Sonicrobots/Midi-to-10WLED/Eagle Files/8x LED Treiber Stage_01_DOCU_Circuit.pdf

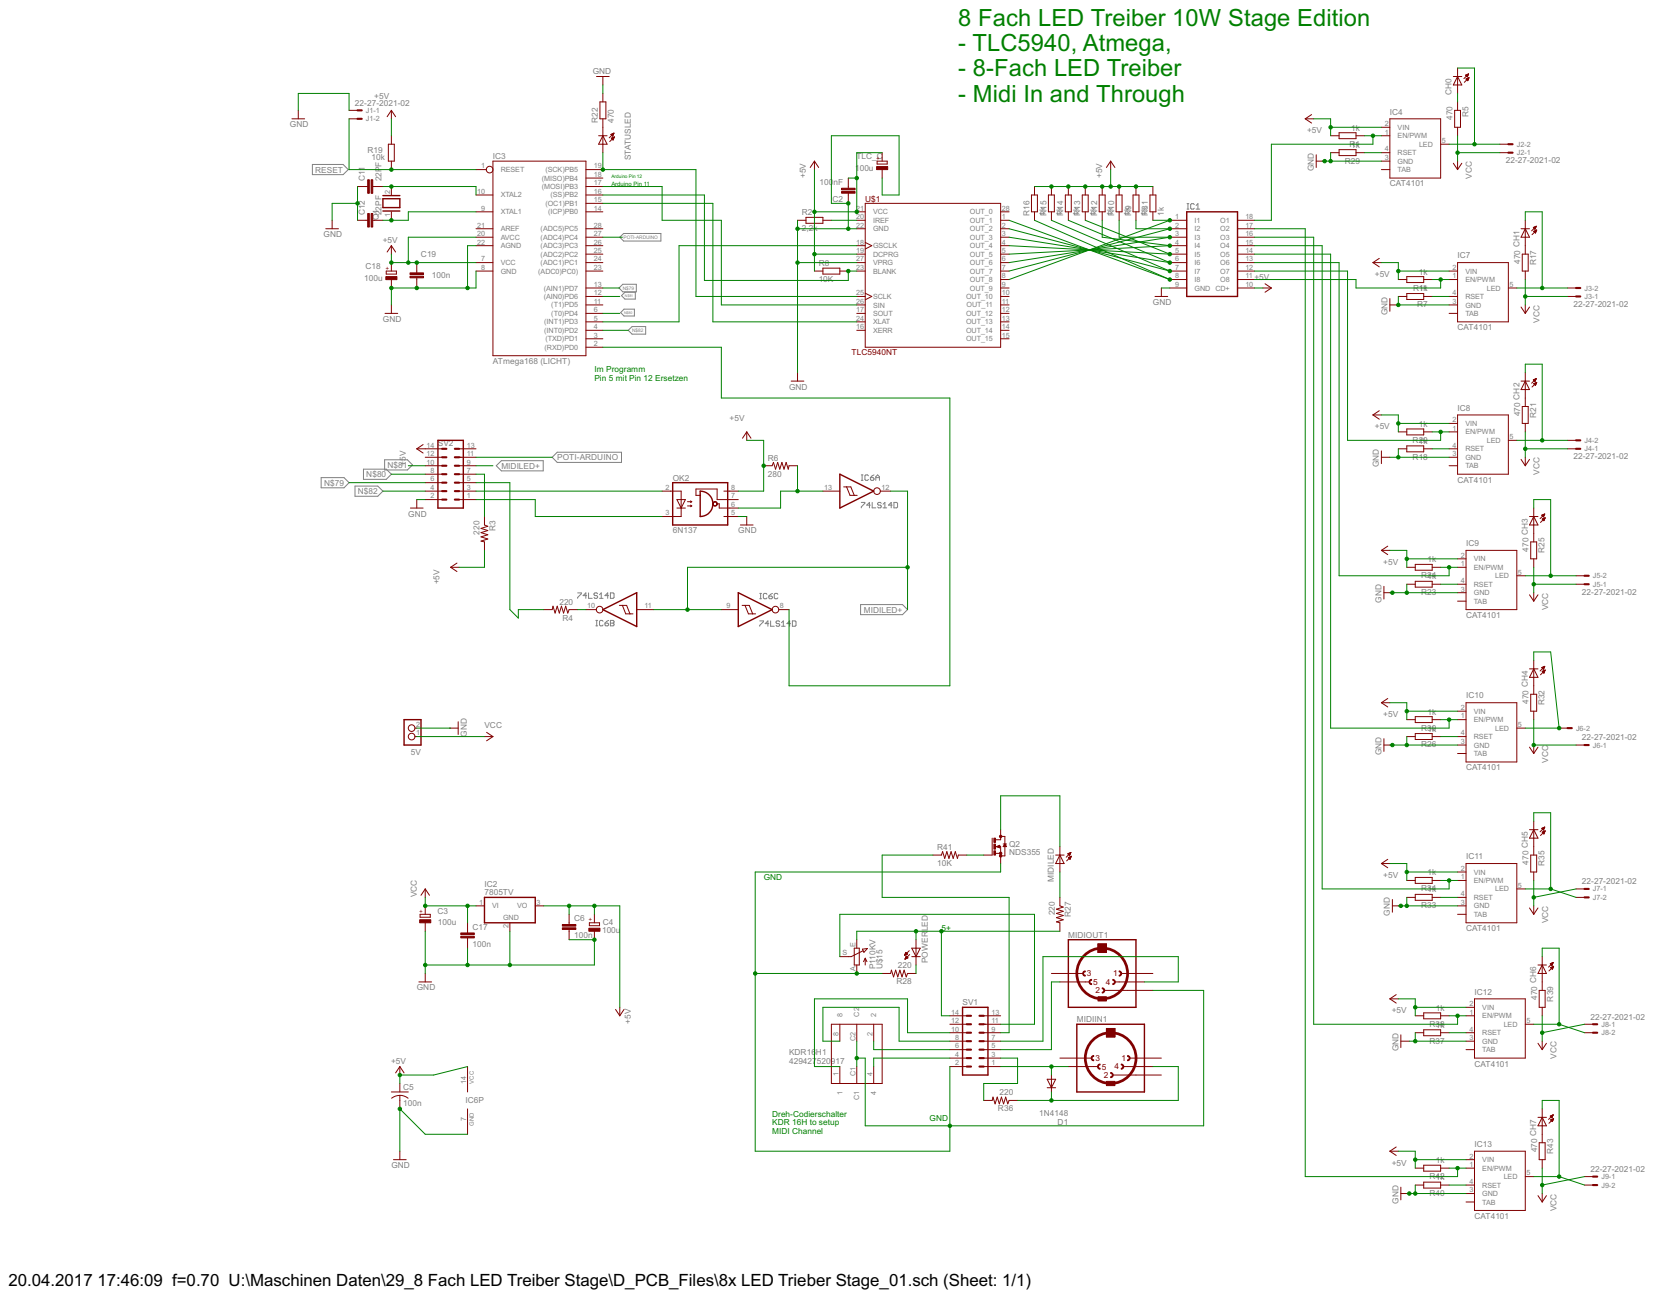
[picture p1: page 1]

+ 8 Fach LED Treiber 10W Stage Edition

- TLC5940, Atmega, - 8-Fach LED Treiber

- Midi In and Through

Arduino Pin 12 Arduino Pin 11

Im Programm
Pin 5 mit Pin 12 Ersetzen

20.04.2017 17:46:09 f=0.70 U:\Maschinen Daten\29_8 Fach LED Treiber Stage\D_PCB_Files\8x LED Trieber Stage_01.sch (Sheet: 1/1)
