Sonicrobots/Midi-to-10WLED/Eagle Files/8x LED Trieber Stage_01_DOCU_top.pdf

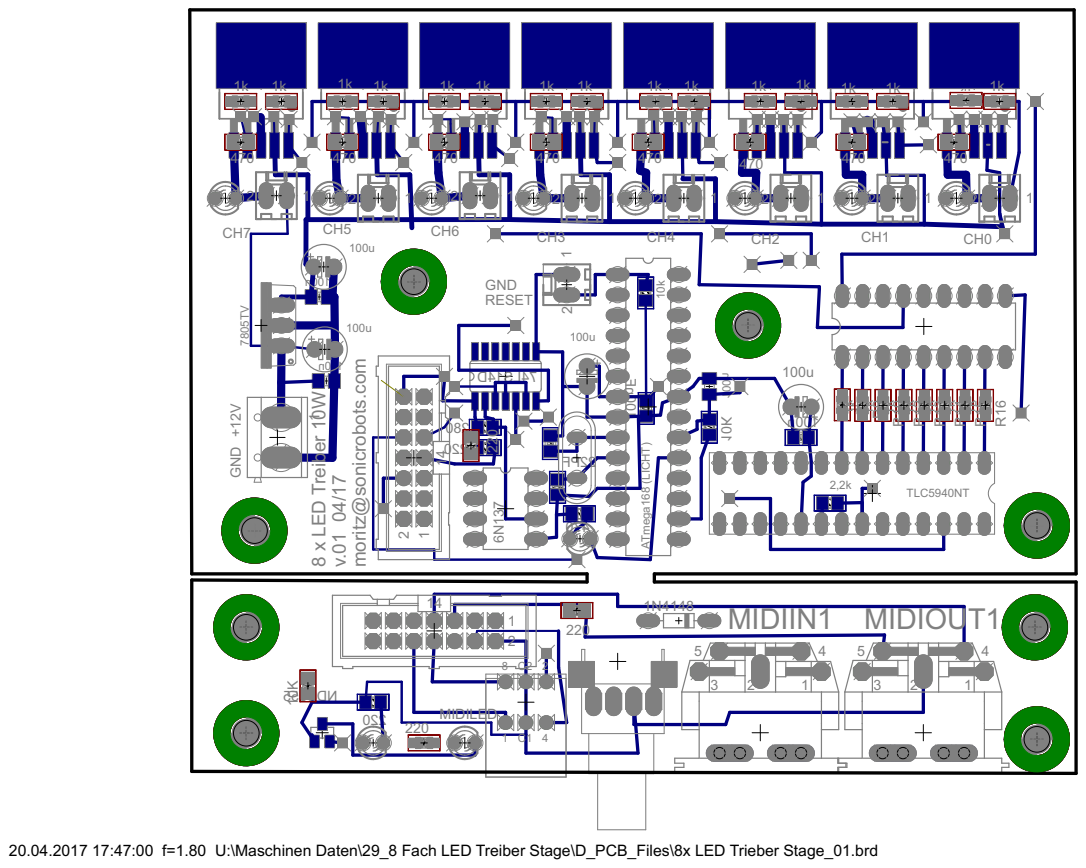
[picture p2: page 1]

20.04.2017 17:47:00 f=1.80 U:\Maschinen Daten\29_8 Fach LED Treiber Stage\D_PCB_Files\8x LED Trieber Stage_01.brd
