Sonicrobots/Midi-to-10WLED/Eagle Files/8x LED Trieber Stage_01.brd

## EAGLE design Eagle Files/8x LED Trieber Stage_01.brd (2017-04-22)

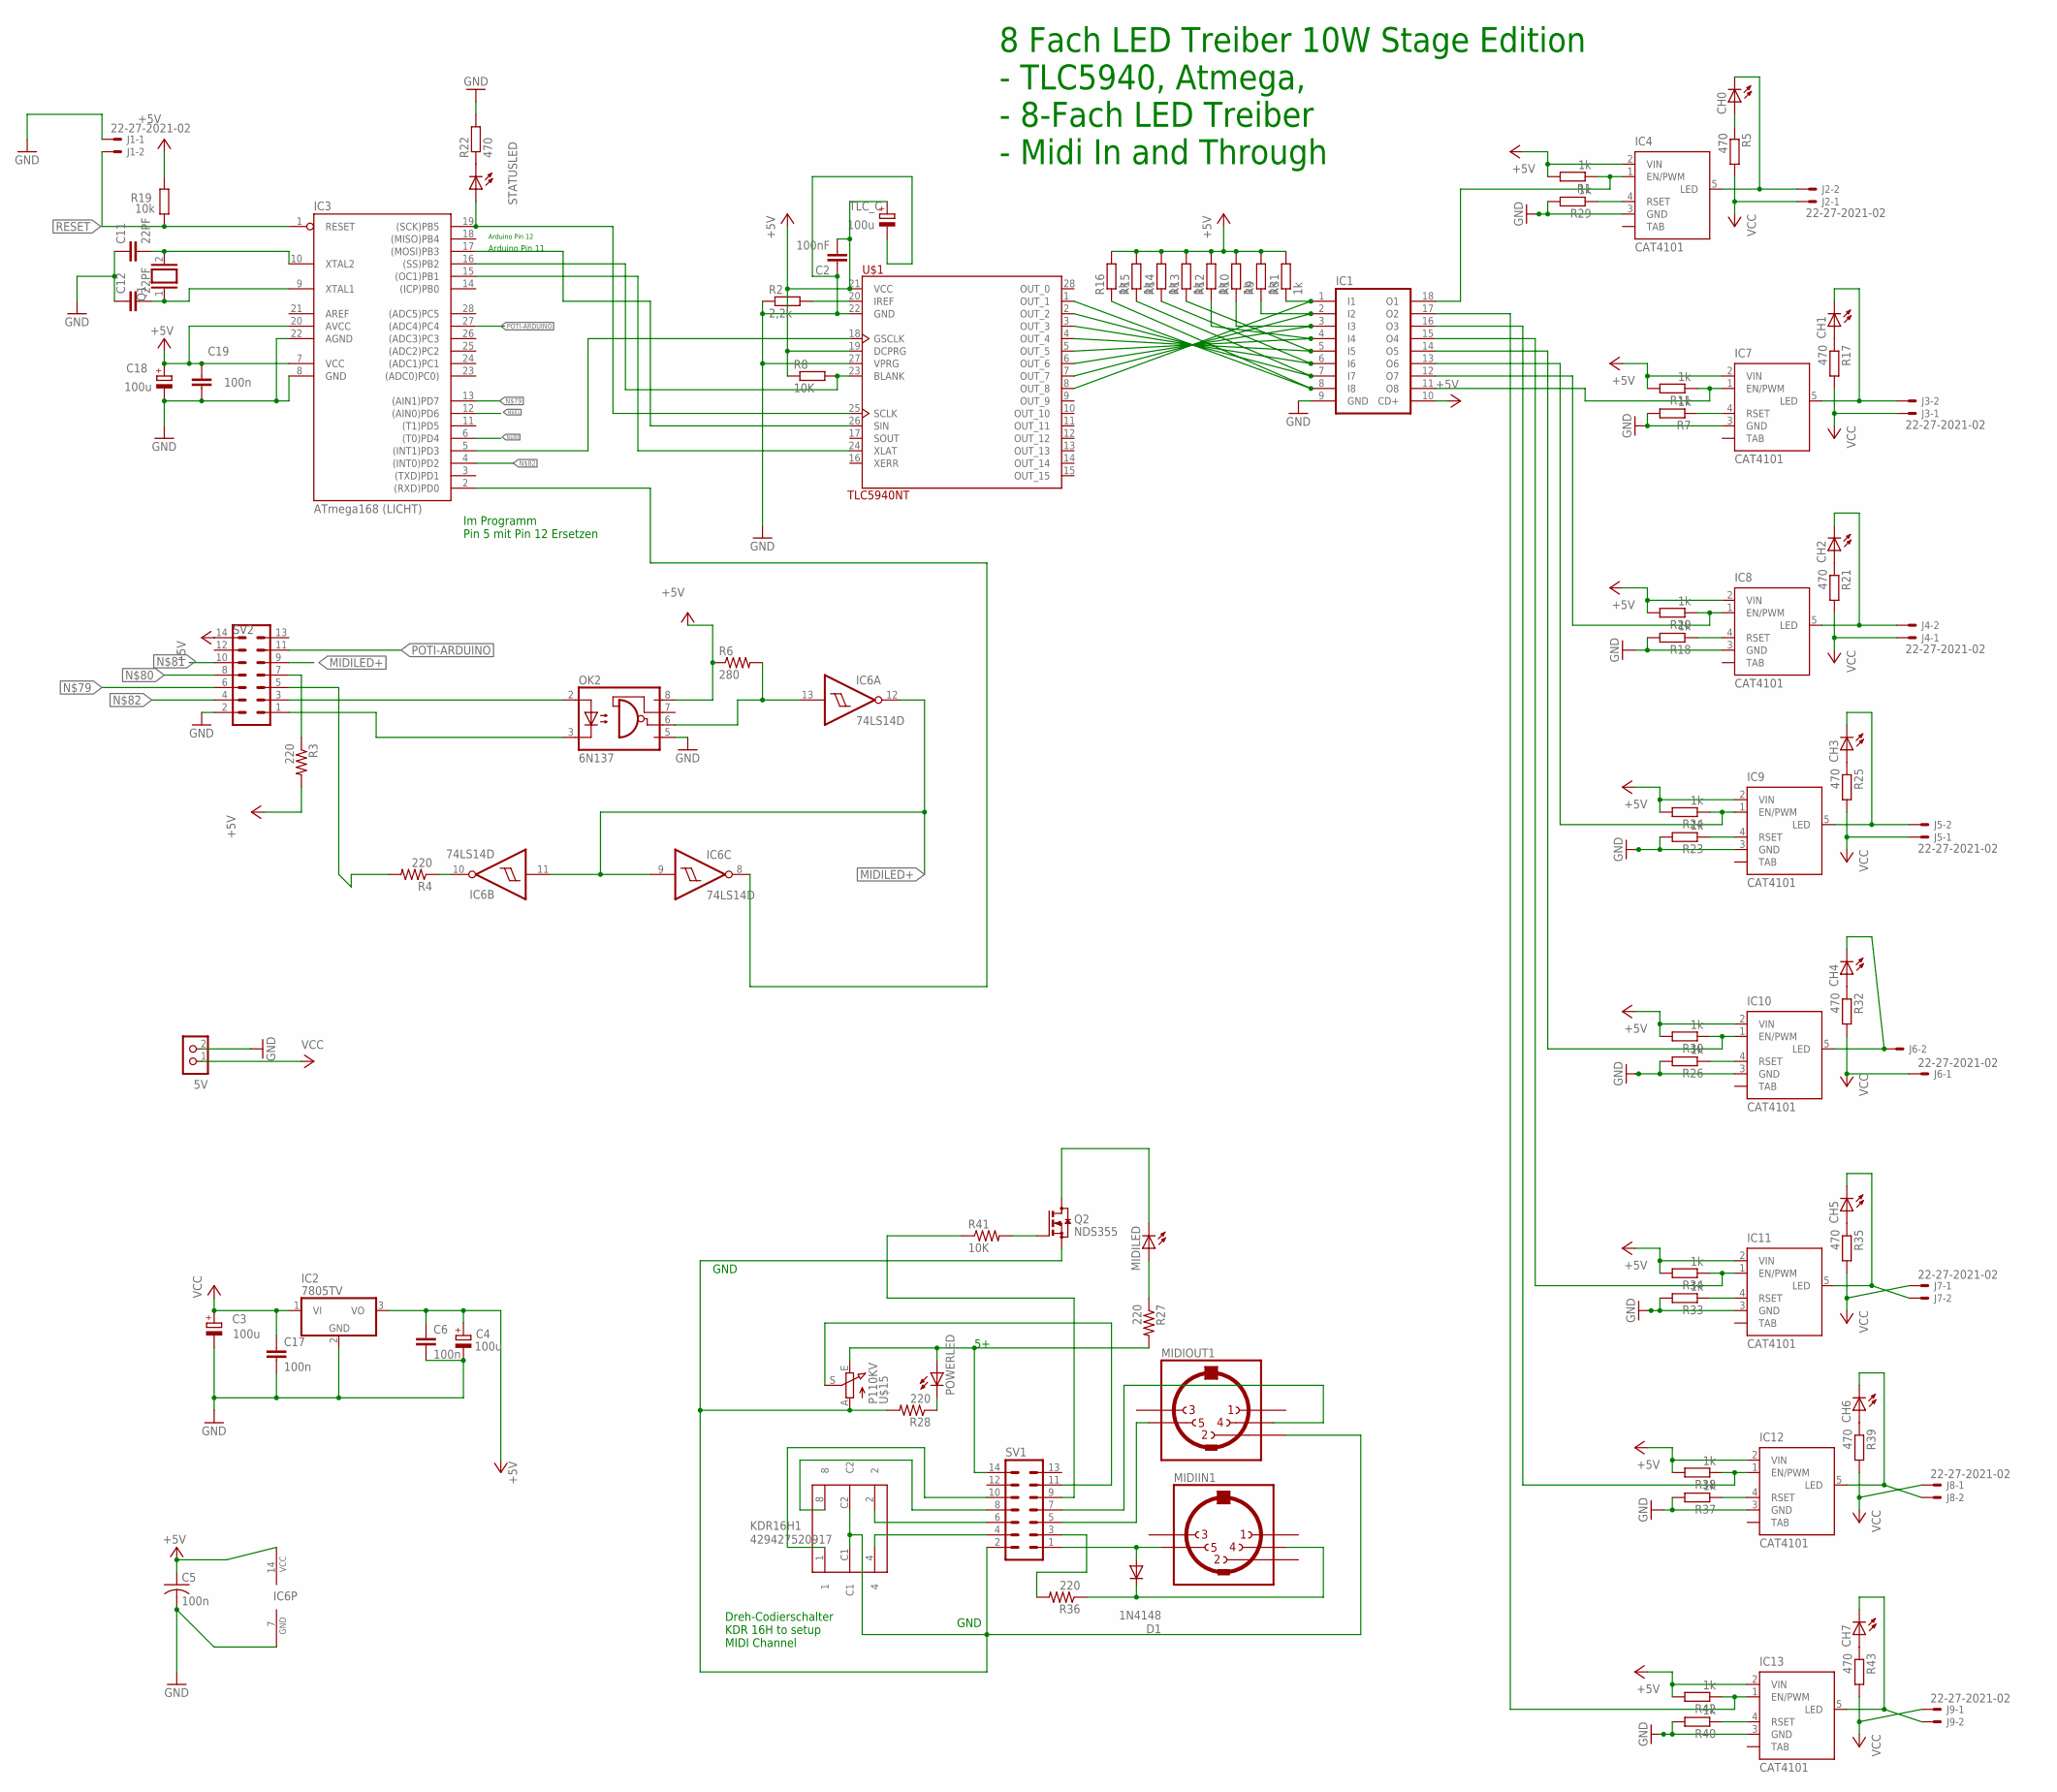
[picture p3: schematic 8x LED Trieber Stage_01.sch]

Parts:
5V: 5V; TERMINAL_BLOCK_2P_5
C2: 100nF; C0805
C3, C4, C18: 100u; E2,5-6
C5: 100n; C0805
C6, C17, C19: 100n; C0805K
C11, C12: 22PF; C0805
CH0, CH1, CH2, CH3, CH4, CH5, CH6, CH7: LED3MM
D1: 1N4148; D-7.5
IC1: IC_ULN2803AN; DIL18
IC2: 7805TV; TO220V
IC3: ATmega168 (LICHT); DIL28-3
IC4, IC7, IC8, IC9, IC10, IC11, IC12, IC13: CAT4101; TO263_5
IC6: 74LS14D; SO14
J1, J2, J3, J4, J5, J6, J7, J8, J9: 22-27-2021-02; 6410-02
KDR16H1: 429427520917
MIDIIN1: MAB5SH
MIDILED: LED3MM
MIDIOUT1: MAB5SH
OK2: 6N137; DIL08; MPN 6N137
POWERLED: LED3MM
Q1: XTAL/S; QS
Q2: NDS355; SOT23
R1, R7, R9, R10, R11, R12, R13, R14, R15, R16, R18, R20, R23, R24, R26, R29, R30, R31, R33, R34, R37, R38, R40, R42: 1k; R0805W
R2: 2,2k; R0805
R3, R4, R28, R36: 220; R0805
R5, R17, R21, R22, R25, R32, R35, R39, R43: 470; M0805
R6: 280; R0805
R8, R41: 10K; R0805
R19: 10k; R0805
R27: 220; R0805W
STATUSLED: LED3MM
SV1, SV2: ML14
TLC_C: 100u; E2,5-6
U$1: TLC5940NT; DIP-28
U$15: P110KV; POT-P110KV

Connections:
+5V: C2.2, C4.+, C5.1, C6.1, C18.+, C19.1, IC1.10 (CD+), IC2.3 (VO), IC3.7 (VCC), IC3.20 (AVCC), IC4.2 (VIN), IC6.14 (VCC), IC7.2 (VIN), IC8.2 (VIN), IC9.2 (VIN), IC10.2 (VIN), IC11.2 (VIN), IC12.2 (VIN), IC13.2 (VIN), OK2.8 (VCC), R1.2, R3.2, R6.1, R8.1, R9.2, R10.2, R11.2, R12.2, R13.2, R14.2, R15.2, R16.2, R19.2, R20.2, R24.2, R30.2, R31.2, R34.2, R38.2, R42.2, SV2.14, TLC_C.+, U$1.19 (DCPRG), U$1.21 (VCC)
GND: 5V.2, C2.1, C3.-, C4.-, C5.2, C6.2, C11.1, C12.1, C17.2, C18.-, C19.2, IC1.9 (GND), IC2.2 (GND), IC3.8 (GND), IC3.22 (AGND), IC4.3 (GND), IC6.7 (GND), IC7.3 (GND), IC8.3 (GND), IC9.3 (GND), IC10.3 (GND), IC11.3 (GND), IC12.3 (GND), IC13.3 (GND), J1.1, OK2.5 (GND), R2.1, R7.2, R18.2, R22.2, R23.2, R26.2, R29.2, R33.2, R37.2, R40.2, SV2.2, TLC_C.-, U$1.22 (GND), U$1.27 (VPRG)
MIDI-2: IC3.2 ((RXD)PD0), IC6.8 (O)
MIDILED+: IC6.9 (I), IC6.11 (I), IC6.12 (O), SV2.9
MIDILED+1: MIDILED.K (C), Q2.3 (D)
MIDI_IN2: R41.1, SV1.9
unnamed: OK2.3 (C), SV2.1
unnamed: IC6.13 (I), OK2.6 (VO), R6.2
unnamed: IC1.1 (I1), R31.1, U$1.8 (OUT_8)
unnamed: IC3.19 ((SCK)PB5), STATUSLED.A, U$1.25 (SCLK)
unnamed: IC1.2 (I2), R9.1, U$1.7 (OUT_7)
unnamed: IC1.3 (I3), R10.1, U$1.6 (OUT_6)
unnamed: IC1.4 (I4), R12.1, U$1.5 (OUT_5)
unnamed: IC3.17 ((MOSI)PB3), U$1.26 (SIN)
unnamed: IC3.16 ((SS)PB2), R8.2, U$1.23 (BLANK)
unnamed: IC7.4 (RSET), R7.1
unnamed: IC1.5 (I5), R13.1, U$1.4 (OUT_4)
unnamed: IC1.6 (I6), R14.1, U$1.3 (OUT_3)
unnamed: IC1.7 (I7), R15.1, U$1.2 (OUT_2)
unnamed: IC3.15 ((OC1)PB1), U$1.24 (XLAT)
unnamed: IC1.11 (O8), IC7.1 (EN/PWM), R11.1
unnamed: IC3.5 ((INT1)PD3), U$1.18 (GSCLK)
unnamed: IC1.8 (I8), R16.1, U$1.1 (OUT_1)
unnamed: D1.A, MIDIIN1.5, SV1.1
unnamed: R2.2, U$1.20 (IREF)
unnamed: KDR16H1.1, SV1.10
unnamed: C12.2, IC3.9 (XTAL1), Q1.1
unnamed: MIDILED.A, R27.1
unnamed: CH1.K (C), IC7.5 (LED), J3.2
unnamed: C11.2, IC3.10 (XTAL2), Q1.2
unnamed: R3.1, SV2.7
unnamed: R22.1, STATUSLED.K (C)
unnamed: IC4.4 (RSET), R29.1
unnamed: CH0.A, R5.1
unnamed: IC1.18 (O1), IC4.1 (EN/PWM), R1.1
unnamed: IC6.10 (O), R4.1
unnamed: R4.2, SV2.5
unnamed: SV1.11, U$15.S
unnamed: D1.C, MIDIIN1.4, R36.1
unnamed: CH0.K (C), IC4.5 (LED), J2.2
unnamed: POWERLED.K (C), R28.1
unnamed: CH1.A, R17.1
unnamed: IC8.4 (RSET), R18.1
unnamed: IC1.12 (O7), IC8.1 (EN/PWM), R20.1
unnamed: CH2.K (C), IC8.5 (LED), J4.2
unnamed: MIDIOUT1.5, SV1.5
unnamed: CH2.A, R21.1
unnamed: IC9.4 (RSET), R23.1
unnamed: IC1.13 (O6), IC9.1 (EN/PWM), R24.1
unnamed: OK2.2 (A), SV2.3
unnamed: CH3.K (C), IC9.5 (LED), J5.2
unnamed: MIDIOUT1.4, SV1.7
unnamed: CH3.A, R25.1
unnamed: IC10.4 (RSET), R26.1
unnamed: IC1.14 (O5), IC10.1 (EN/PWM), R30.1
unnamed: CH4.K (C), IC10.5 (LED), J6.2
unnamed: CH4.A, R32.1
unnamed: IC11.4 (RSET), R33.1
unnamed: KDR16H1.4, SV1.4
unnamed: IC1.15 (O4), IC11.1 (EN/PWM), R34.1
unnamed: KDR16H1.8, SV1.8
unnamed: KDR16H1.2, SV1.6
unnamed: CH5.K (C), IC11.5 (LED), J7.2
unnamed: CH5.A, R35.1
unnamed: POWERLED.A, R27.2, SV1.14, U$15.E
unnamed: IC12.4 (RSET), R37.1
unnamed: IC1.16 (O3), IC12.1 (EN/PWM), R38.1
unnamed: R36.2, SV1.3
unnamed: CH6.K (C), IC12.5 (LED), J8.2
unnamed: CH6.A, R39.1
unnamed: Q2.1 (G), R41.2
unnamed: KDR16H1.C1, KDR16H1.C2, MIDIOUT1.2, Q2.2 (S), R28.2, SV1.2, U$15.A
unnamed: IC13.4 (RSET), R40.1
unnamed: IC1.17 (O2), IC13.1 (EN/PWM), R42.1
unnamed: IC3.13 ((AIN1)PD7), SV2.6
unnamed: IC3.6 ((T0)PD4), SV2.8
unnamed: IC3.12 ((AIN0)PD6), SV2.10
unnamed: IC3.4 ((INT0)PD2), SV2.4
unnamed: CH7.K (C), IC13.5 (LED), J9.2
unnamed: CH7.A, R43.1
POTI-ARDUINO: IC3.27 ((ADC4)PC4), SV2.11
RESET: IC3.1 (RESET), J1.2, R19.1
VCC: 5V.1, C3.+, C17.1, IC2.1 (VI), J2.1, J3.1, J4.1, J5.1, J6.1, J7.1, J8.1, J9.1, R5.2, R17.2, R21.2, R25.2, R32.2, R35.2, R39.2, R43.2

Notes on the sheet:
8 Fach LED Treiber 10W Stage Edition - TLC5940, Atmega, - 8-Fach LED Treiber - Midi In and Through
Arduino Pin 12
Arduino Pin 11
Dreh-Codierschalter KDR 16H to setup MIDI Channel
GND
Im Programm Pin 5 mit Pin 12 Ersetzen

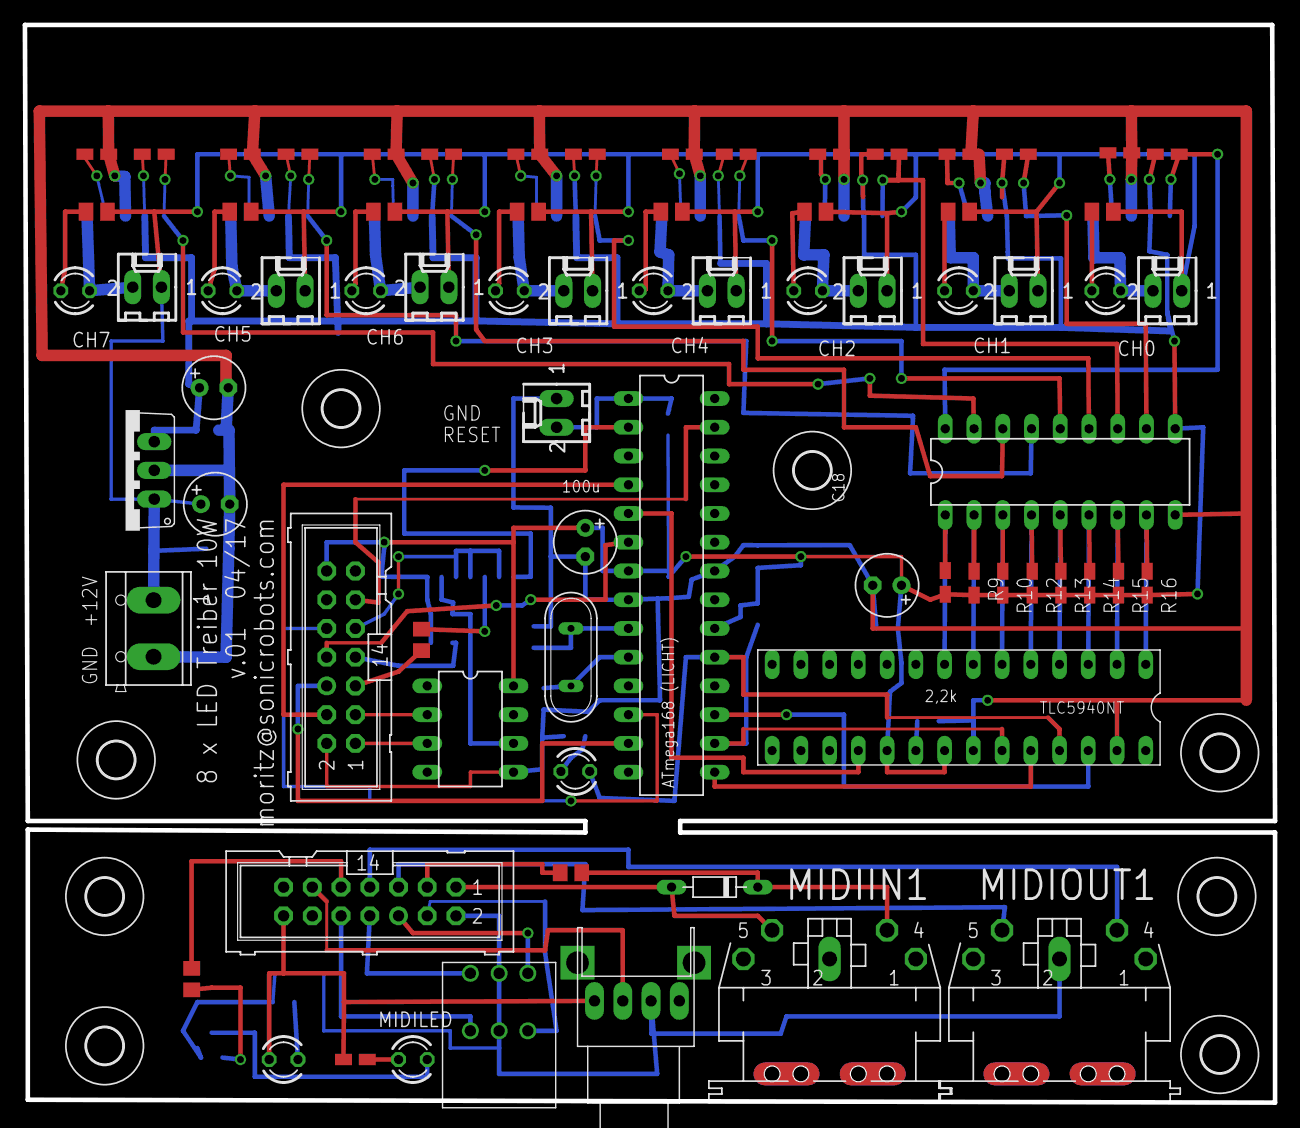
[picture p4: board 8x LED Trieber Stage_01.brd from above]

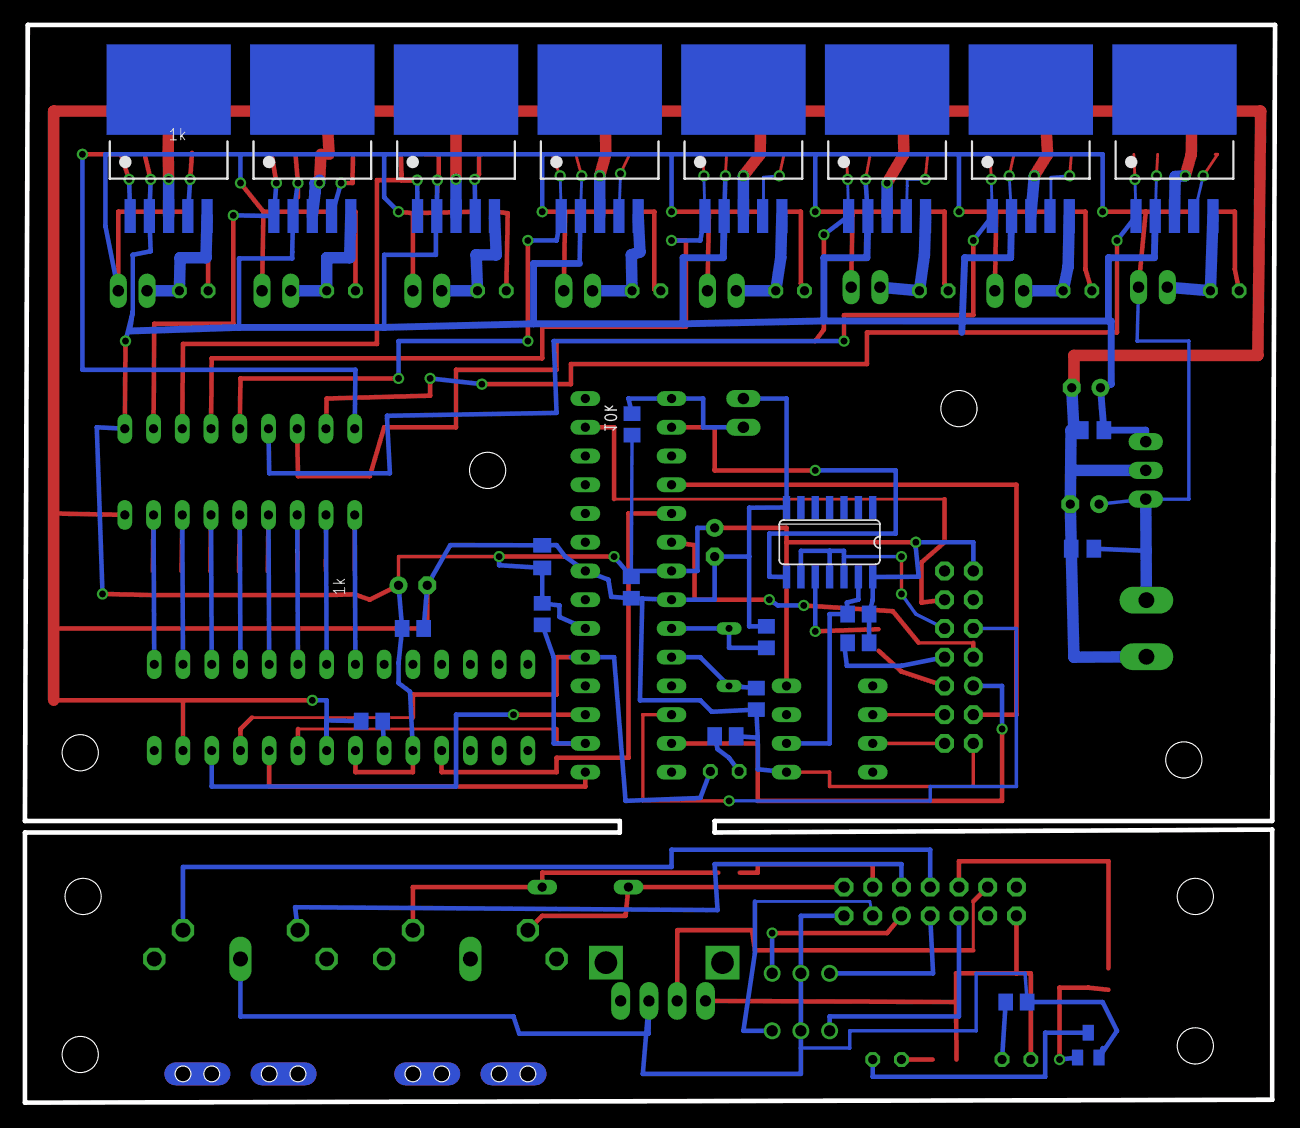
[picture p5: board 8x LED Trieber Stage_01.brd from below]

Board: 2 copper layers, 110.5 x 95.2 mm, 106 parts (24 on the bottom side), 83 nets.

Other parts of the board:
U$2, U$3, U$4, U$5, U$6, U$7, U$8, U$9: 3,2
