Sonicrobots/Midi-to-10WLED/(commit log)

2017-04-22 Eagle Files v01 added
    [8x LED Trieber Stage_01.brd, 8x LED Trieber Stage_01.sch]
2017-04-22 Arduino Files added
2017-05-06 Arduino and Eagle Fixes
    Channels in Arduino Coded fixed, Annotations in eagle added
    [8x LED Trieber Stage_01.sch]
