Sonicrobots/Midi-to-10WLED/(notices)

Notices in the files:
parts and their libraries:
tlc5940: Hereby placed under Public Domain
Eagle_Wuerth_Elektronik_Switch: Copyright: Würth Elektronik
